bwhitman/onsen/docs/pics/whole.jpg

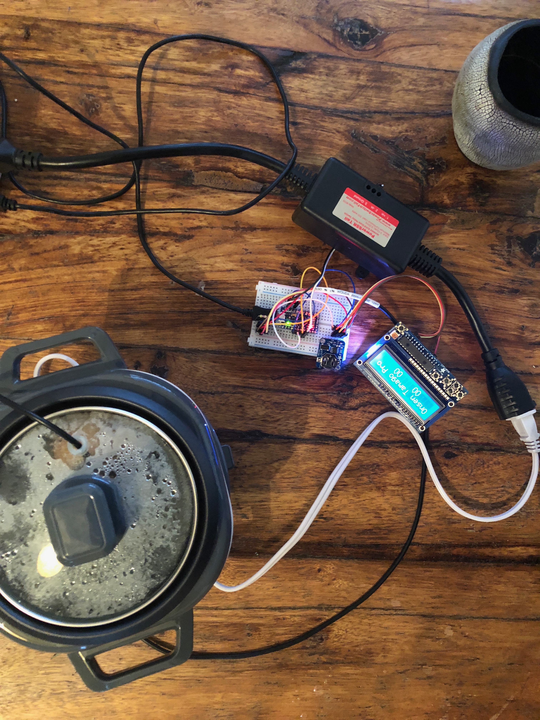
docs/pics/whole.jpg
